CDFER/openRiverSense/images/ATGM332D-5N31-SouthFacingWindow-SkyView.png

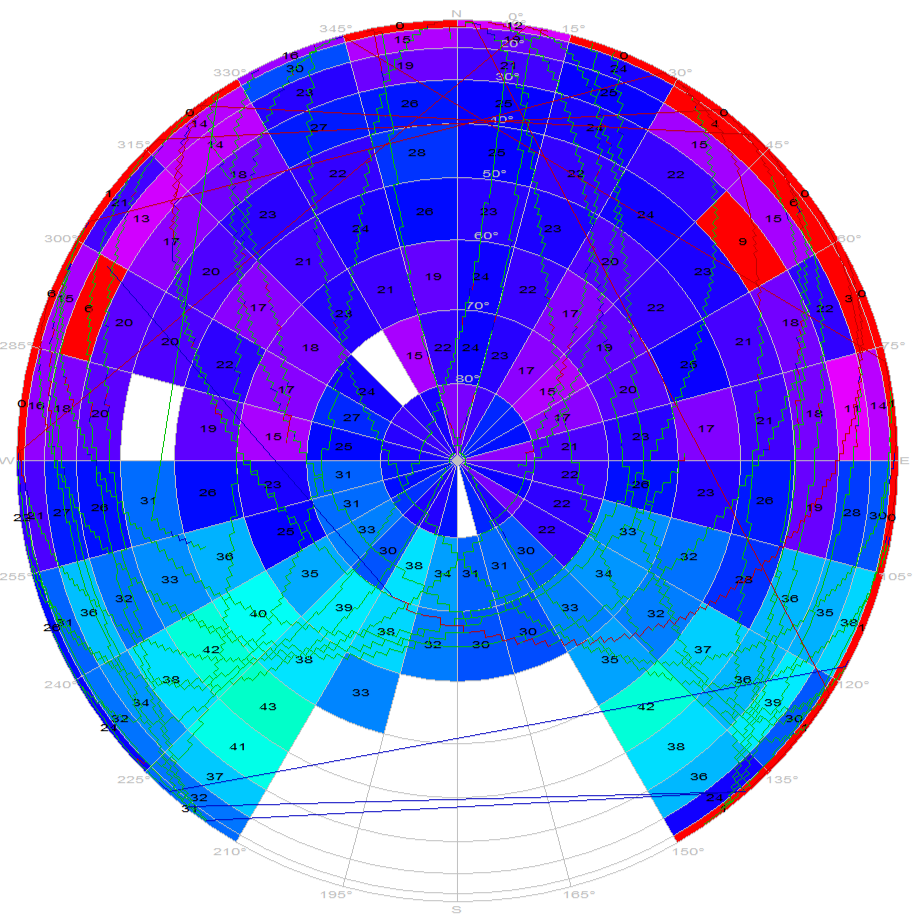
images/ATGM332D-5N31-SouthFacingWindow-SkyView.png
