CDFER/openRiverSense/README.md

**openRiverSense - Water Quality Tester**
=====================================

### Overview

### Features

### Assembly

### Usage

### Improvements for V2

* Reduce interference between Battery Charging and GPS Antenna
* Backlight powered by CC buck power source?
* Better Shielding on Screen SPI bus to enable reliable 80Mhz bus speeds
* Improve GPS RTC backup power source (CR2032, direct from Lithium-ion)?
