CDFER/openRiverSense/images/ATGM332D-5N31-SouthFacingWindow-Deviation.png

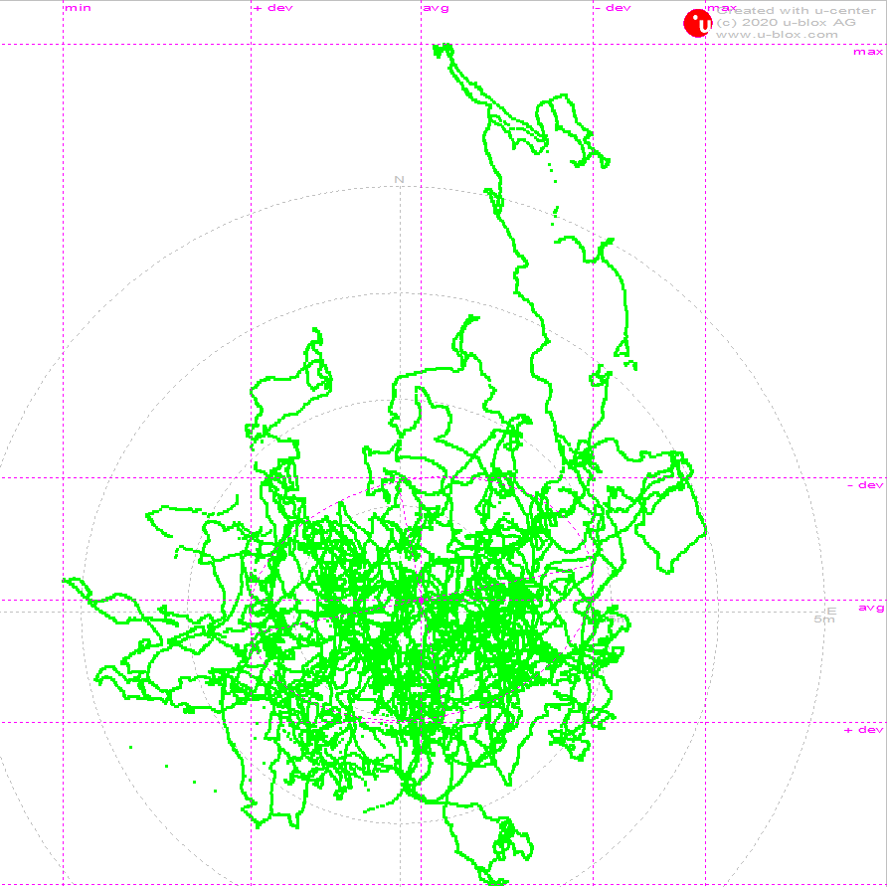
images/ATGM332D-5N31-SouthFacingWindow-Deviation.png
