CDFER/openRiverSense/hardware/openRiverSense/Buttons.3mf

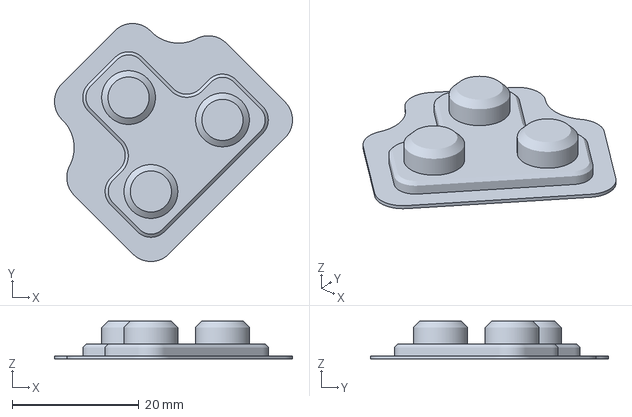
[picture p3: CAD file, 2024-08-28]
hardware/openRiverSense/Buttons.3mf
37.6 x 37.6 x 6.00 mm
