CDFER/openRiverSense/hardware/openRiverSense/Bottom Shell.3mf

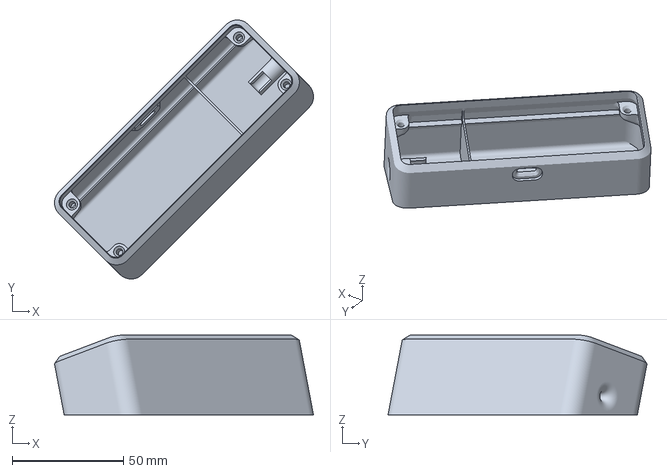
[picture p4: CAD file, 2024-08-28]
hardware/openRiverSense/Bottom Shell.3mf
116.2 x 116.2 x 35.8 mm
