CDFER/openRiverSense/hardware/openRiverSense/Top Shell.stl

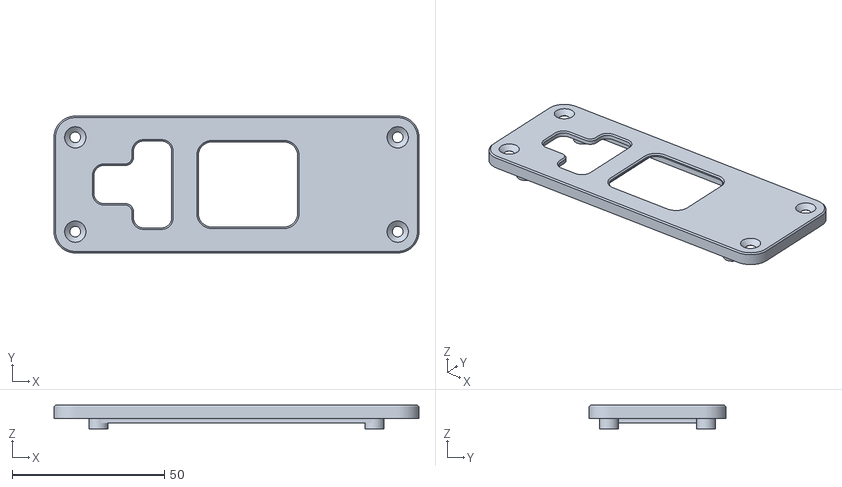
[picture p5: CAD file, 2024-08-28]
hardware/openRiverSense/Top Shell.stl
120.0 x 45.0 x 7.85
