CDFER/openRiverSense/(list of files, cad)

Other CAD files:
hardware/openRiverSense/Bottom Shell.stl
