CDFER/openRiverSense/hardware/probeDaughterBoard/probeDaughterBoard.kicad_pcb

## KiCad design hardware/probeDaughterBoard/probeDaughterBoard.kicad_pcb (2024-08-28)

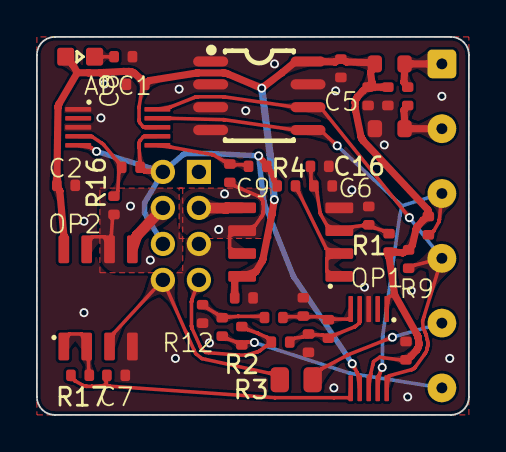
[picture p6: board probeDaughterBoard.kicad_pcb from above]

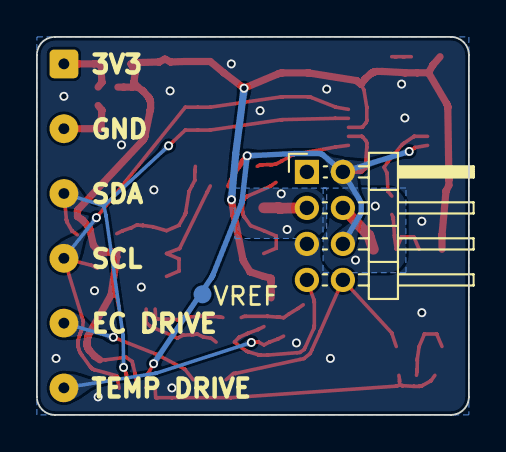
[picture p7: board probeDaughterBoard.kicad_pcb from below]

Board: 2 copper layers, 24.0 x 21.0 mm, 41 parts (2 on the bottom side), 25 nets.

Parts:
ADC1, ADC2: ADS1015; MSOP-10_L3.0-W3.0-P0.50-LS5.0-BL
C1, C2, C3, C5, C6: 100nF; 0402_1005Metric
C4: 0402,10uF,6.3V,X5R; 0402_1005Metric
C7, C9, C11: 0402,20pF,50V,C0G; 0402_1005Metric
C8, C12: 0402,100nF,16V,X7R; 0402_1005Metric
C10, C16: 0402,1uF,25V,X5R; 0402_1005Metric
C13: 0402,220nF,16V,X7R; 0402_1005Metric
C14, C15: 0402,22nF,50V,X7R; 0402_1005Metric
EEPROM1: M24C64-RMN6TP; SOIC-8_L5.0-W4.0-P1.27-LS6.0-BL
FB1, FB2: 0603,200mA; 0603_1608Metric
J1: Conn_02x04_Odd_Even; PinHeader_2x04_P2.00mm_Horizontal
J4: Conn_01x06; SolderWire-0.1sqmm_1x06_P3.6mm_D0.4mm_OD1mm
LED1: 0603,Green; LED0603
OP1, OP2: MCP6002; SOIC-8_L4.9-W3.9-P1.27-LS6.0-BL
R1: 0402,2.2k; 0402_1005Metric
R2, R11, R12: 0402,10k; 0402_1005Metric
R3: 0805,470k; 0805_2012Metric
R4, R13, R14, R15, R16, R17: 0402,100; 0402_1005Metric
R5: 0402,47k; 0402_1005Metric
R6: 0402,12k; 0402_1005Metric
R9, R10: 0402,4.7k; 0402_1005Metric

Connections:
+3.3V: ADC1.8 (VDD), ADC2.1 (ADDR), ADC2.8 (VDD), C1.1, C2.1, C3.1, C5.1, C8.1, C10.1, C12.1, EEPROM1.8 (VCC), FB1.1, LED1.2 (A), OP1.8 (+VDD), OP2.8 (+VDD), R6.1, R9.1, R10.1
/3V3_IN: C4.1, FB1.2, J4.1
/EC_DRIVE: J4.5, R3.1
/EC_IN: J1.8, OP2.3 (+), R3.2
/EC_OUT: ADC2.6 (AIN2), C7.1, R17.2
/GND_IN: C4.2, FB2.2, J4.2
/ORP_IN: J1.4, OP2.5 (+)
/ORP_OUT: ADC1.4 (AIN0), C11.1, R16.2
/ORP_RING: OP2.6 (-), OP2.7, R16.1
/PH_IN: J1.3, OP1.5 (+)
/PH_OUT: ADC1.6 (AIN2), C9.1, R15.2
/PH_RING: OP1.6 (-), OP1.7, R15.1
/SCL: ADC1.10 (SCL), ADC2.10 (SCL), EEPROM1.6 (SCL), J4.4, R9.2
/SDA: ADC1.9 (SDA), ADC2.9 (SDA), EEPROM1.5 (SDA), J4.3, R10.2
/TEMP_DRIVE: J4.6, R2.1, R11.1
/TEMP_IN: J1.7, R2.2, R14.1
/TEMP_REF: R11.2, R12.1, R13.1
/VREF: ADC1.5 (AIN1), ADC1.7 (AIN3), ADC2.7 (AIN3), C9.2, C11.2, J1.2, J1.6, R4.2
GND: ADC1.1 (ADDR), ADC1.3 (GND), ADC2.3 (GND), C1.2, C2.2, C3.2, C5.2, C6.2, C7.2, C8.2, C10.2, C12.2, C14.2, C15.1, C16.2, EEPROM1.1 (A0), EEPROM1.2 (A1), EEPROM1.3 (A2), EEPROM1.4 (VSS), EEPROM1.7 (#WC), FB2.1, J1.5, OP1.4 (-VSS), OP2.4 (-VSS), R1.2, R5.2, R12.2
unnamed: ADC2.4 (AIN0), C13.1, C15.2, R14.2
unnamed: ADC2.5 (AIN1), C13.2, C14.1, R13.2
unnamed: C6.1, C16.1, OP1.3 (+), R1.1, R6.2
unnamed: LED1.1 (C), R5.1
unnamed: OP1.1, OP1.2 (-), R4.1
unnamed: OP2.1, OP2.2 (-), R17.1
