CDFER/openRiverSense/hardware/openRiverSense/openRiverSense.kicad_pcb

## KiCad design hardware/openRiverSense/openRiverSense.kicad_pcb (2024-08-28)

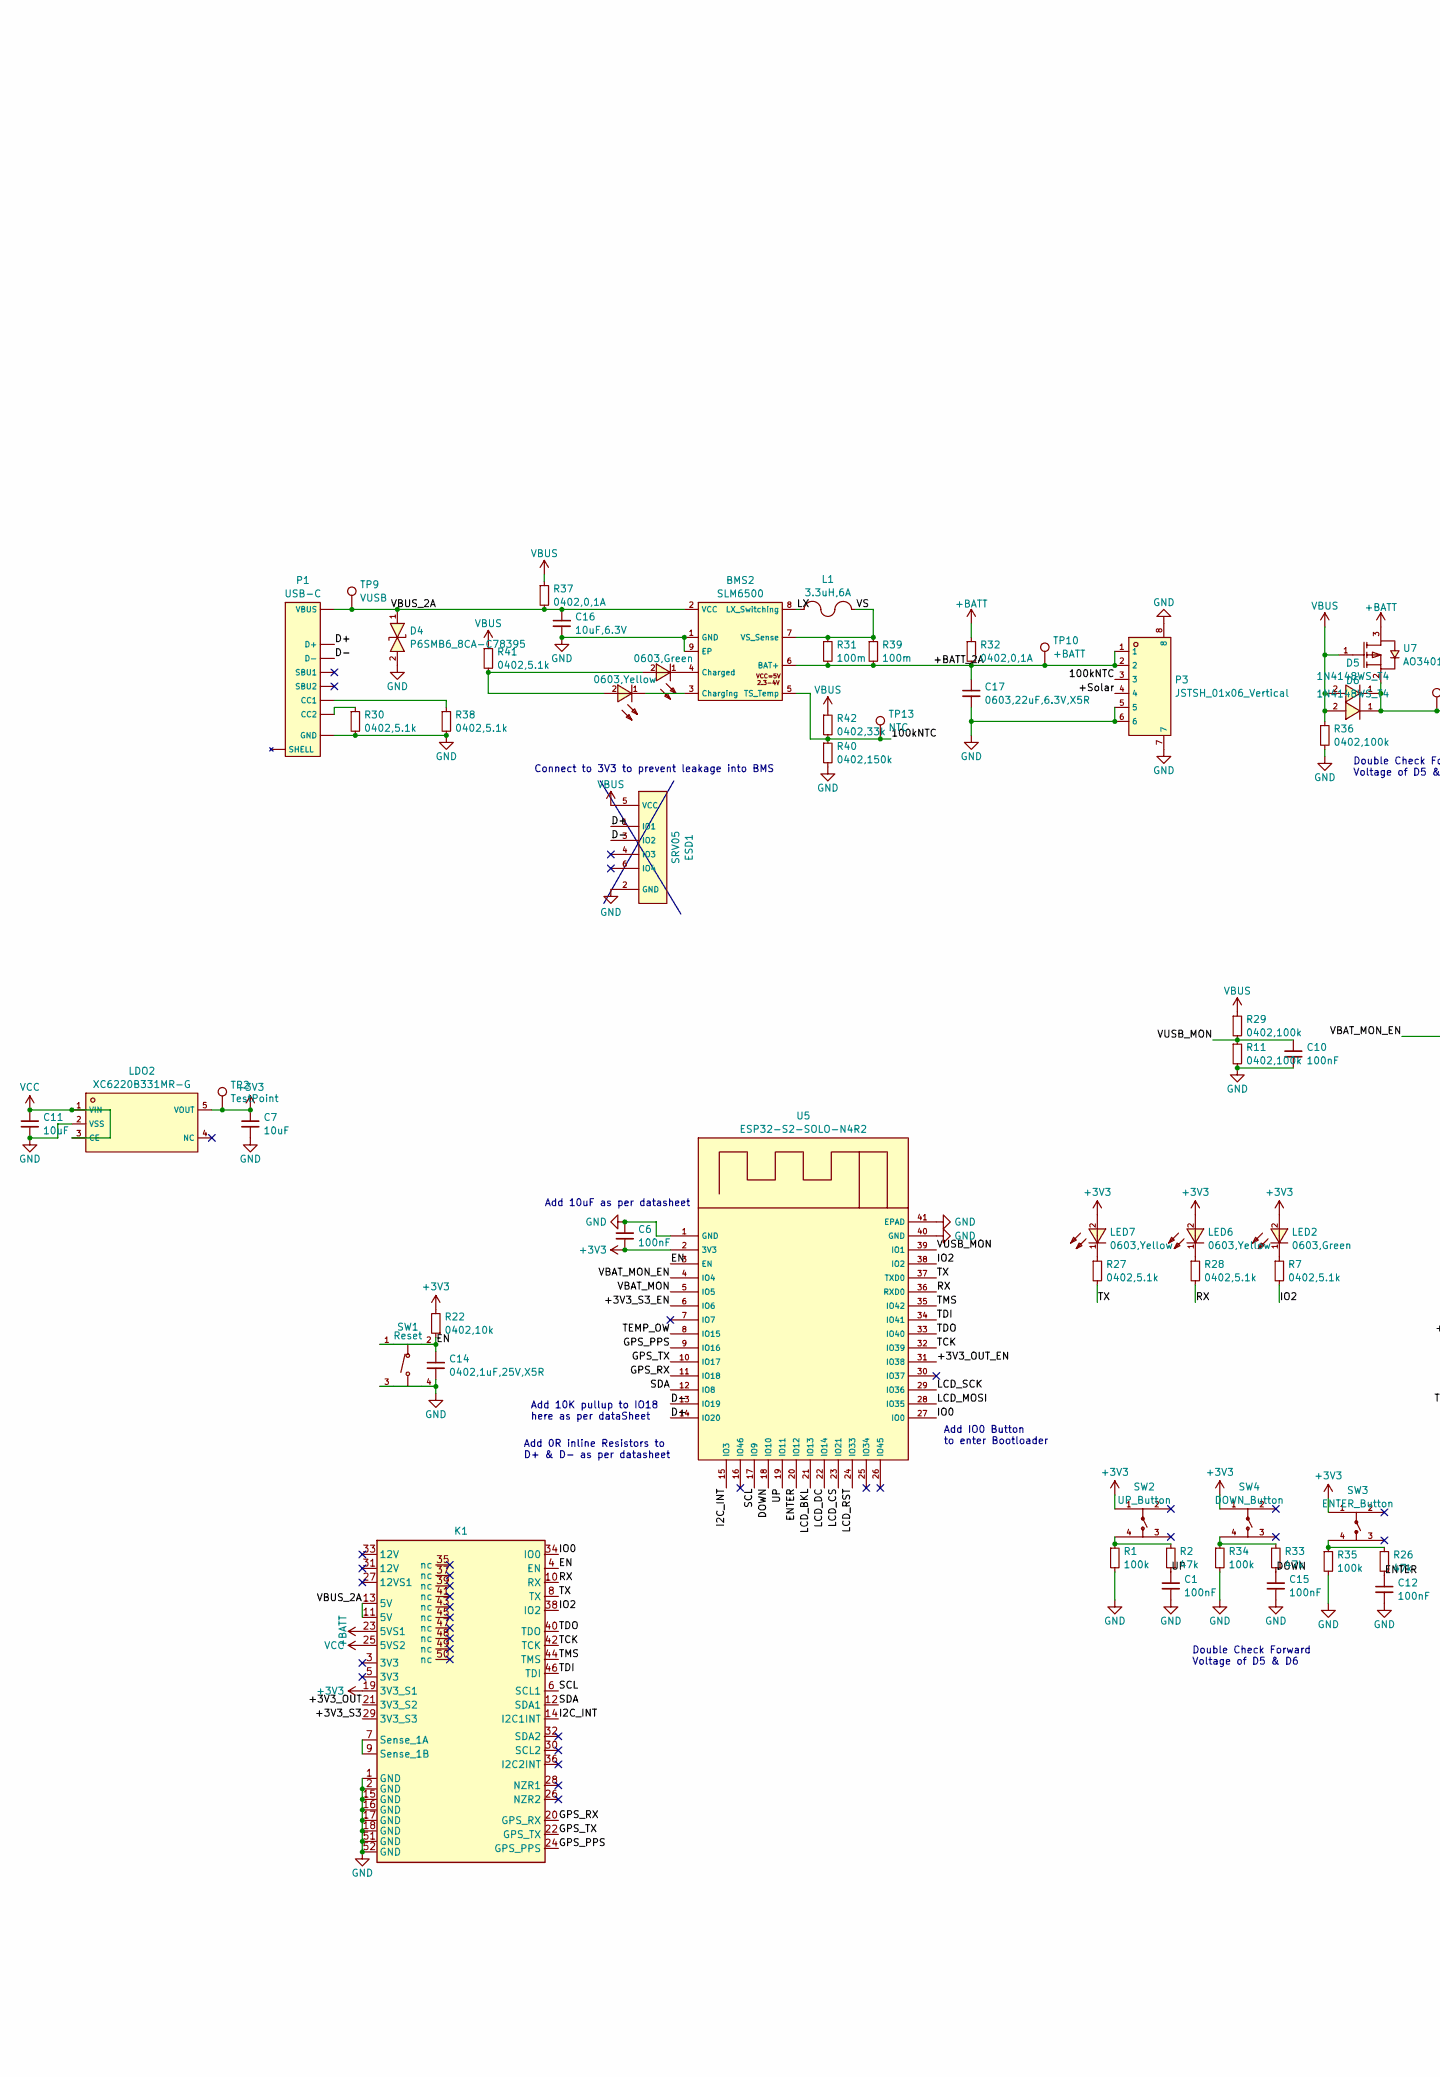
[picture p8: schematic openRiverSense.kicad_sch, part in row 1, column 1]

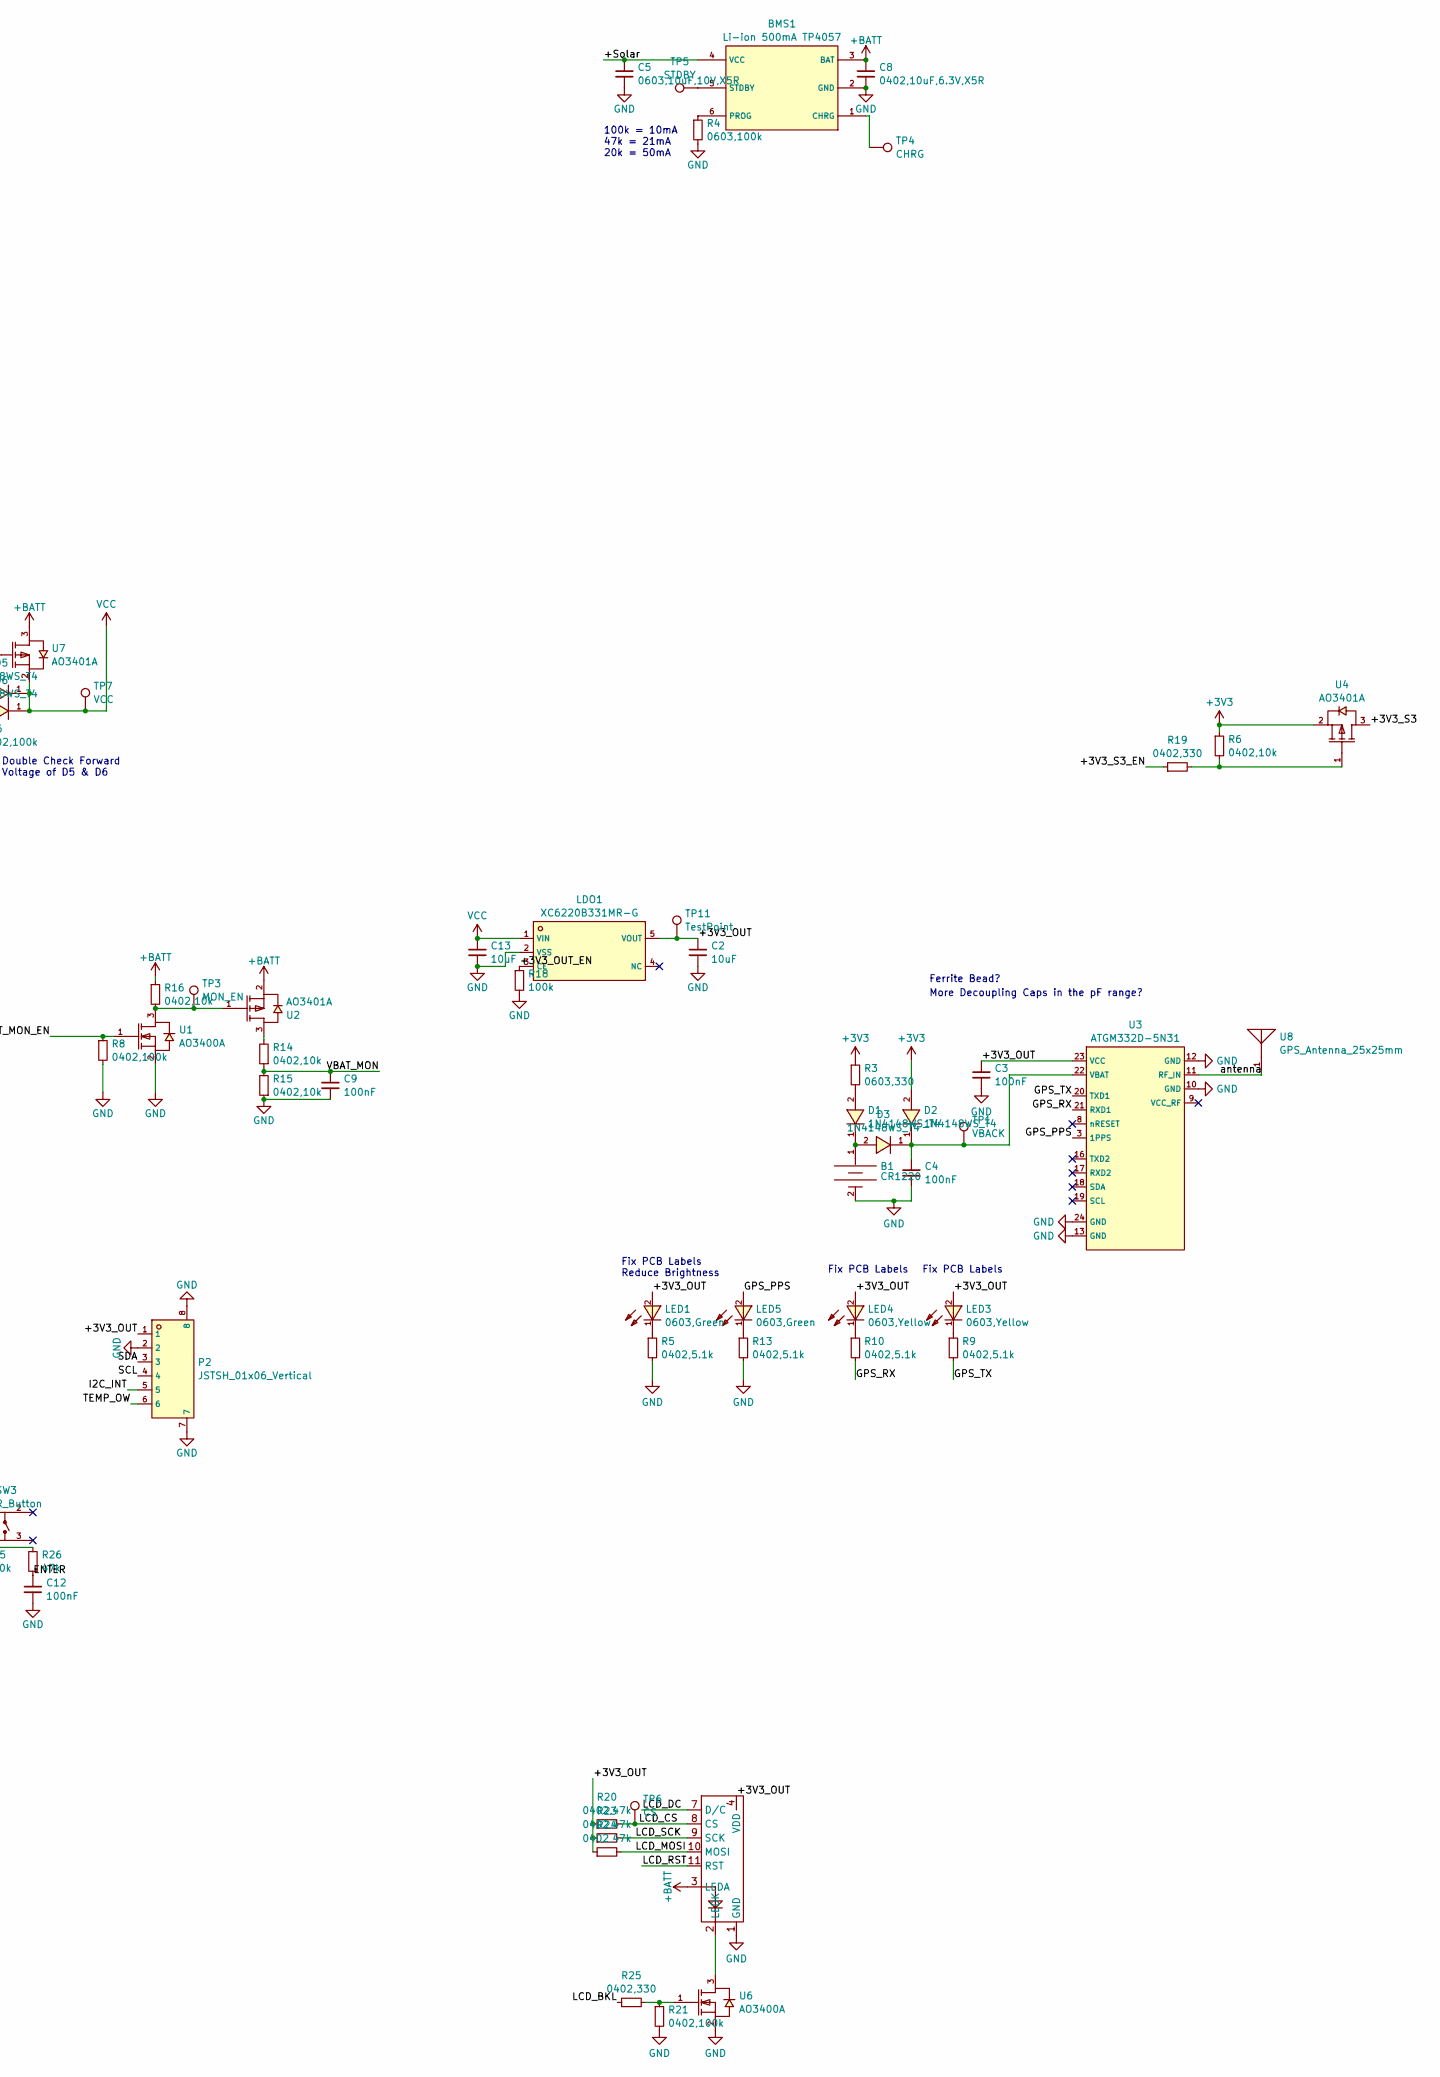
[picture p9: schematic openRiverSense.kicad_sch, part in row 1, column 2]

Parts:
B1: CR1220; BAT-SMD_BS-12-B2AA002; LCSC C964721
BMS1: Li-ion 500mA TP4057; SOT-23-6_L2.9-W1.6-P0.95-LS2.8-BL; LCSC C12044
BMS2: SLM6500; SOP-8_L4.9-W3.9-P1.27-LS6.0-BL-EP; LCSC C130315
C1, C3, C4, C6, C9, C10, C12, C15: 100nF; 0402_1005Metric; MFGPN CL05B104KO5NNNC; LCSC C1525
C2, C7, C11, C13: 10uF; 0402_1005Metric; MFGPN CL05A106MQ5NUNC; LCSC C15525
C5: 0603,10uF,10V,X5R; 0603_1608Metric; MFGPN CL10A106KP8NNNC; LCSC C19702
C8: 0402,10uF,6.3V,X5R; 0402_1005Metric; MFGPN CL05A106MQ5NUNC; LCSC C15525
C14: 0402,1uF,25V,X5R; 0402_1005Metric; MFGPN CL05A105KA5NQNC; LCSC C52923
C16: 10uF,6.3V; 0402_1005Metric; MFGPN CL05A106MQ5NUNC; LCSC C15525
C17: 0603,22uF,6.3V,X5R; 0603_1608Metric; MFGPN CL10A226MQ8NRNC; LCSC C59461
D1, D2, D3, D5, D6: 1N4148WS_T4; SOD-323_L1.8-W1.3-LS2.5-RD; LCSC C2128
D4: P6SMB6_8CA-C78395; SMB_L4.6-W3.6-LS5.3-BI; LCSC C78395
ESD1: SRV05; SOT-23-6_L2.9-W1.6-P0.95-LS2.8-BR; LCSC C85364
K1: mpcie-full-card
L1: 3.3uH,6A; IND-SMD_L7.3-W6.8; LCSC C394166
LDO1, LDO2: XC6220B331MR-G; SOT-25_L3.0-W1.6-P0.95-LS2.8-TL; LCSC C86534
LED1, LED2, LED5, LED9: 0603,Green; LED0603; LCSC C72043
LED3, LED4, LED6, LED7, LED8: 0603,Yellow; LED0603; LCSC C72038
P1: USB-C; USB-C-SMD_G-SWITCH_GT-USB-7010ASV; LCSC C2988369
P2, P3: JSTSH_01x06_Vertical; CONN-SMD_6P-P1.00_DEALON_1.0-6PS; LCSC C2904988
R1, R18, R34, R35: 100k; 0402_1005Metric; MFGPN 0402WGF1003TCE; LCSC C25741
R2, R26, R33: 47k; 0402_1005Metric; MFGPN 0402WGF4702TCE; LCSC C25792
R3: 0603,330; 0603_1608Metric; MFGPN 0603WAF3300T5E; LCSC C23138
R4: 0603,100k; 0603_1608Metric; MFGPN 0603WAF1003T5E; LCSC C25803
R5, R7, R9, R10, R13, R27, R28, R30, R38, R41: 0402,5.1k; 0402_1005Metric; MFGPN 0402WGF5101TCE; LCSC C25905
R6, R14, R15, R16, R22: 0402,10k; 0402_1005Metric; MFGPN 0402WGF1002TCE; LCSC C25744
R8, R11, R21, R29, R36: 0402,100k; 0402_1005Metric; MFGPN 0402WGF1003TCE; LCSC C25741
R19, R25: 0402,330; 0402_1005Metric; MFGPN 0402WGF3300TCE; LCSC C25104
R20, R23, R24: 0402,47k; 0402_1005Metric; MFGPN 0402WGF4702TCE; LCSC C25792
R31, R39: 100m; 1206_3216Metric; MFGPN 1206W4F100LT5E; LCSC C25334
R32, R37: 0402,0,1A; 0402_1005Metric; MFGPN 0402WGF0000TCE; LCSC C17168
R40: 0402,150k; 0402_1005Metric; MFGPN 0402WGF1503TCE; LCSC C25755
R42: 0402,33k; 0402_1005Metric; MFGPN 0402WGF3302TCE; LCSC C25779
SW1: Reset; SW-SMD_4P-L5.1-W5.1-P3.70-LS6.5-TL-2; LCSC C318884
SW2: UP_Button; SW-TH_4P-L12.0-W12.0-P5.00-LS12.5-EH; LCSC C718965
SW3: ENTER_Button; SW-TH_4P-L12.0-W12.0-P5.00-LS12.5-EH; LCSC C718965
SW4: DOWN_Button; SW-TH_4P-L12.0-W12.0-P5.00-LS12.5-EH; LCSC C718965
TFT1: IPS Display
TP1: VBACK; TestPoint_Pad_D1.0mm
TP2, TP11: TestPoint; TestPoint_Pad_D1.0mm
TP3: MON_EN; TestPoint_Pad_D1.0mm
TP4: CHRG; TestPoint_Pad_D1.0mm
TP5: STDBY; TestPoint_Pad_D1.0mm
TP6: CS; TestPoint_Pad_D1.0mm
TP7: VCC; TestPoint_Pad_D1.0mm
TP9: VUSB; TestPoint_Pad_D1.0mm
TP10: +BATT; TestPoint_Pad_D1.0mm
TP13: NTC; TestPoint_Pad_D1.0mm
U1, U6: AO3400A; SOT-23-3_L2.9-W1.6-P1.90-LS2.8-BR; LCSC C20917
U2, U4, U7: AO3401A; SOT-23_L2.9-W1.3-P1.90-LS2.4-BR; LCSC C15127
U3: ATGM332D-5N31; GSM-SMD_ATGM332D-5N31; LCSC C128659
U5: ESP32-S2-SOLO-N4R2; WIRELM-SMD_ESP32-S3-WROOM-1; LCSC C3013947
U8: GPS_Antenna_25x25mm; ANT-TH_KH-GPS252504-WY; LCSC C962216

Connections:
+3V3: C6.2, C7.1, D2.2 (A), K1.19 (3V3_S1), LDO2.5 (VOUT), LED2.2 (A), LED6.2 (A), LED7.2 (A), R3.1, R6.1, R22.2, SW2.1, SW3.1, SW4.1, TP2.1, U4.2 (S), U5.2 (3V3)
+BATT: BMS1.3 (BAT), C8.1, K1.23 (5VS1), R16.1, R32.1, TFT1.3 (LEDA), U2.2 (S), U7.3 (D)
/100kNTC: BMS2.5 (TS_Temp), P3.3, R40.1, R42.2, TP13.1
/+3V3_OUT: C2.1, C3.1, K1.21 (3V3_S2), LDO1.5 (VOUT), LED1.2 (A), LED3.2 (A), LED4.2 (A), P2.1, R20.1, R23.1, R24.1, TFT1.4 (VDD), TP11.1, U3.23 (VCC)
/+3V3_OUT_EN: LDO1.3 (CE), R18.1, U5.31 (IO38)
/+3V3_S3: K1.29 (3V3_S3), U4.3 (D)
/+3V3_S3_EN: R19.1, U5.6 (IO6)
/+BATT_2A: BMS2.6 (BAT+), C17.1, P3.1, P3.2, R31.2, R32.2, R39.2, TP10.1
/+Solar: BMS1.4 (VCC), C5.1, P3.4
/D+: ESD1.1 (IO1), P1.DP (D+), U5.14 (IO20)
/D-: ESD1.3 (IO2), P1.DN (D-), U5.13 (IO19)
/DOWN: C15.1, R33.1, U5.18 (IO10)
/EN: C14.1, K1.4 (EN), R22.1, SW1.1 (A), SW1.2 (B), U5.3 (EN)
/ENTER: C12.1, R26.1, U5.20 (IO12)
/GPS_PPS: K1.24 (GPS_PPS), LED5.2 (A), U3.3 (1PPS), U5.9 (IO16)
/GPS_RX: K1.20 (GPS_RX), R10.2, U3.21 (RXD1), U5.11 (IO18)
/GPS_TX: K1.22 (GPS_TX), R9.2, U3.20 (TXD1), U5.10 (IO17)
/I2C_INT: K1.14 (I2C1INT), P2.5, U5.15 (IO3)
/IO0: K1.34 (IO0), U5.27 (IO0)
/IO2: K1.38 (IO2), R7.2, U5.38 (IO2)
/LCD_BKL: R25.1, U5.21 (IO13)
/LCD_CS: R20.2, TFT1.8 (CS), TP6.1, U5.23 (IO21)
/LCD_DC: TFT1.7 (D/C), U5.22 (IO14)
/LCD_MOSI: R24.2, TFT1.10 (MOSI), U5.28 (IO35)
/LCD_RST: TFT1.11 (RST), U5.24 (IO33)
/LCD_SCK: R23.2, TFT1.9 (SCK), U5.29 (IO36)
/LX: BMS2.8 (LX_Switching), L1.1
/RX: K1.10 (RX), R28.2, U5.36 (RXD0)
/SCL: K1.6 (SCL1), P2.4, U5.17 (IO9)
/SDA: K1.12 (SDA1), P2.3, U5.12 (IO8)
/TCK: K1.42 (TCK), U5.32 (IO39)
/TDI: K1.46 (TDI), U5.34 (IO41)
/TDO: K1.40 (TDO), U5.33 (IO40)
/TEMP_OW: P2.6, U5.8 (IO15)
/TMS: K1.44 (TMS), U5.35 (IO42)
/TX: K1.8 (TX), R27.2, U5.37 (TXD0)
/UP: C1.1, R2.1, U5.19 (IO11)
/VBAT_MON: C9.1, R14.1, R15.2, U5.5 (IO5)
/VBAT_MON_EN: R8.1, U1.1 (G), U5.4 (IO4)
/VBUS_2A: BMS2.2 (VCC), C16.1, D4.1, K1.11 (5V), K1.13 (5V), P1.3 (VBUS), R37.2, TP9.1
/VS: BMS2.7 (VS_Sense), L1.2, R31.1, R39.1
/VUSB_MON: C10.1, R11.1, R29.2, U5.39 (IO1)
/antenna: U3.11 (RF_IN), U8.1 (ANT)
GND: B1.2 (-), BMS1.2 (GND), BMS2.1 (GND), BMS2.9 (EP), C1.2, C2.2, C3.2, C4.2, C5.2, C6.1, C7.2, C8.2, C9.2, C10.2, C11.2, C12.2, C13.2, C14.2, C15.2, C16.2, C17.2, D4.2, ESD1.2 (GND), K1.1 (GND), K1.2 (GND), K1.15 (GND), K1.16 (GND), K1.17 (GND), K1.18 (GND), K1.51 (GND), K1.52 (GND), LDO1.2 (VSS), LDO2.2 (VSS), P1.2 (GND), P2.2, P2.7, P2.8, P3.5, P3.6, P3.7, P3.8, R1.2, R4.2, R5.2, R8.2, R11.2, R13.2, R15.1, R18.2, R21.2, R30.2, R34.2, R35.2, R36.2, R38.2, R40.2, SW1.3 (C), SW1.4 (D), TFT1.1 (GND), U1.2 (S), U3.10 (GND), U3.12 (GND), U3.13 (GND), U3.24 (GND), U5.1 (GND), U5.40 (GND), U5.41 (EPAD), U6.2 (S)
unnamed: B1.1 (+), D1.1 (K), D3.2 (A)
unnamed: BMS1.1 (CHRG), TP4.1
unnamed: BMS1.6 (PROG), R4.1
unnamed: BMS1.5 (STDBY), TP5.1
unnamed: BMS2.4 (Charged), LED9.1 (C)
unnamed: BMS2.3 (Charging), LED8.1 (C)
unnamed: D1.2 (A), R3.2
unnamed: C4.1, D2.1 (K), D3.1 (K), TP1.1, U3.22 (VBAT)
unnamed: K1.7 (Sense_1A), K1.9 (Sense_1B)
unnamed: LED1.1 (C), R5.1
unnamed: LED2.1 (C), R7.1
unnamed: LED3.1 (C), R9.1
unnamed: LED4.1 (C), R10.1
unnamed: LED5.1 (C), R13.1
unnamed: LED6.1 (C), R28.1
unnamed: LED7.1 (C), R27.1
unnamed: LED8.2 (A), LED9.2 (A), R41.2
unnamed: P1.CC1, R38.1
unnamed: P1.CC2, R30.1
unnamed: R1.1, R2.2, SW2.4
unnamed: R26.2, R35.1, SW3.4
unnamed: R33.2, R34.1, SW4.4
unnamed: TFT1.2 (LEDK), U6.3 (D)
unnamed: R16.2, TP3.1, U1.3 (D), U2.1 (G)
unnamed: R14.2, U2.3 (D)
unnamed: R6.2, R19.2, U4.1 (G)
unnamed: R21.1, R25.2, U6.1 (G)
VBUS: D5.2 (A), D6.2 (A), ESD1.5 (VCC), R29.1, R36.1, R37.1, R41.1, R42.1, U7.1 (G)
VCC: C11.1, C13.1, D5.1 (K), D6.1 (K), K1.25 (5VS2), LDO1.1 (VIN), LDO2.1 (VIN), LDO2.3 (CE), TP7.1, U7.2 (S)

Notes on the sheet:
Add 10K pullup to IO18 here as per dataSheet
Double Check Forward Voltage of D5 & D6
Add 10uF as per datasheet
More Decoupling Caps in the pF range?
Fix PCB Labels Reduce Brightness
Fix PCB Labels
Add 0R inline Resistors to D+ & D- as per datasheet
Ferrite Bead?
Add IO0 Button to enter Bootloader
Connect to 3V3 to prevent leakage into BMS
100k = 10mA 47k = 21mA 20k = 50mA

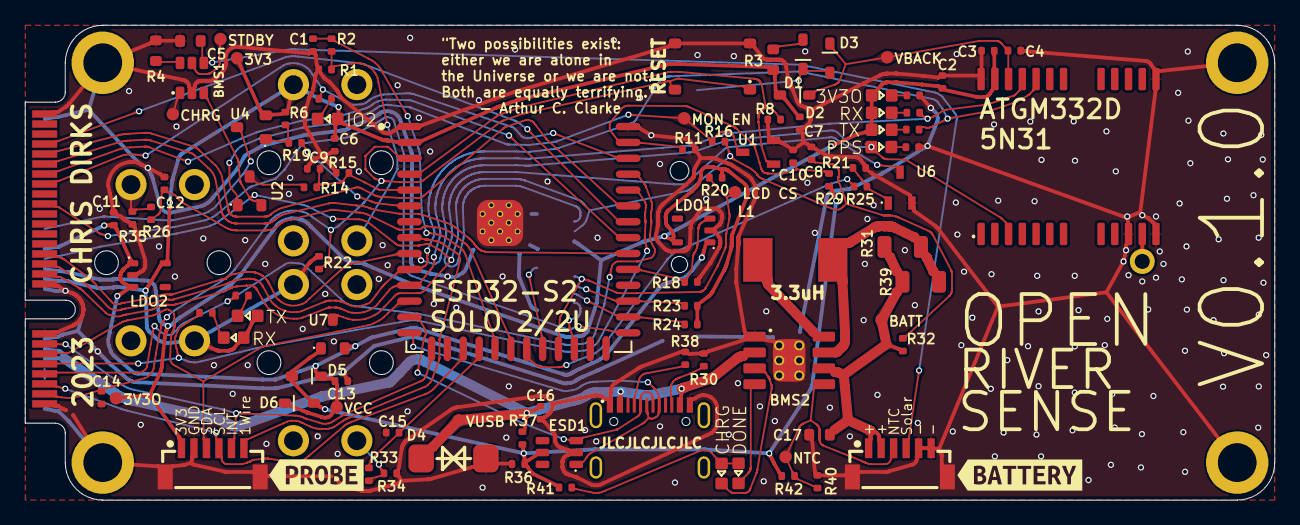
[picture p10: board openRiverSense.kicad_pcb from above]

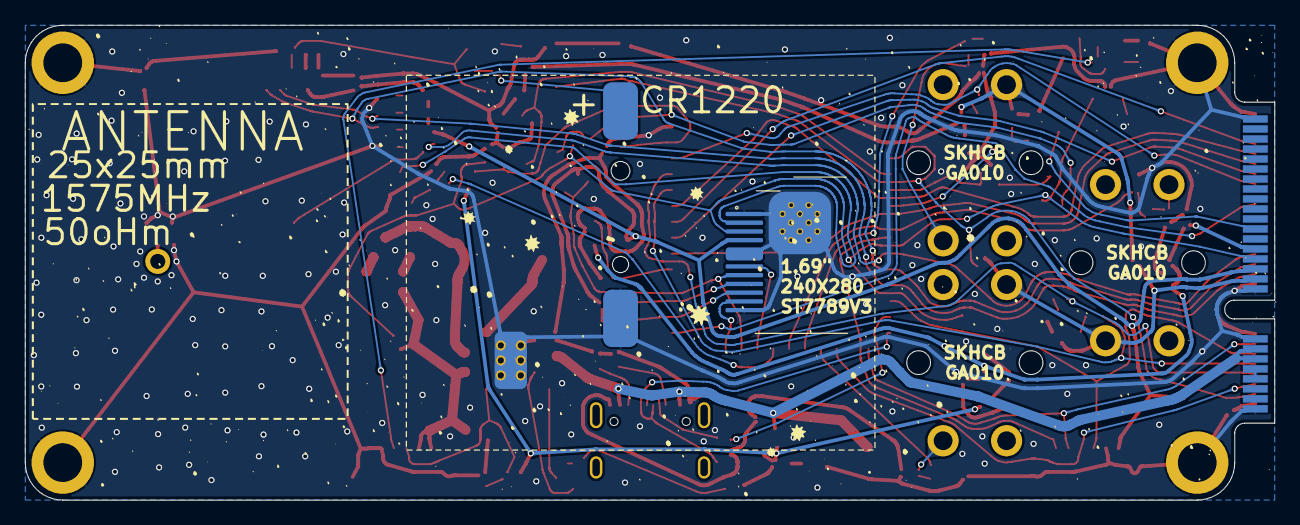
[picture p11: board openRiverSense.kicad_pcb from below]

Board: 2 copper layers, 100.0 x 38.0 mm, 109 parts (7 on the bottom side), 73 nets.

Other parts of the board:
kibuzzard-1: G***; kibuzzard-651F6E89
kibuzzard-2: G***; kibuzzard-651F6E67
