CDFER/openRiverSense/src/usb.h

#include "Adafruit_SPIFlash.h"
#include "Adafruit_TinyUSB.h"
#include "SPI.h"
#include "SdFat.h"

// file system object from SdFat
FatVolume fatfs;

// ESP32 use same flash device that store code.
// Therefore there is no need to specify the SPI and SS
Adafruit_FlashTransport_ESP32 flashTransport;
Adafruit_SPIFlash flash(&flashTransport);

// USB Mass Storage object
Adafruit_USBD_MSC usb_msc;

bool fs_formatted;	// Check if flash is formatted and ready to use
bool fs_changed;	// Set to true when write to flash

// Callback invoked when received READ10 command.
// Copy disk's data to buffer (up to bufsize) and
// return number of copied bytes (must be multiple of block size)
int32_t msc_read_cb(uint32_t lba, void *buffer, uint32_t bufsize) {
	// Note: SPIFLash Bock API: readBlocks/writeBlocks/syncBlocks
	// already include 4K sector caching internally. We don't need to cache it, yahhhh!!
	return flash.readBlocks(lba, (uint8_t *)buffer, bufsize / 512) ? bufsize : -1;
}

// Callback invoked when received WRITE10 command.
// Process data in buffer to disk's storage and
// return number of written bytes (must be multiple of block size)
int32_t msc_write_cb(uint32_t lba, uint8_t *buffer, uint32_t bufsize) {
	// Note: SPIFLash Bock API: readBlocks/writeBlocks/syncBlocks
	// already include 4K sector caching internally. We don't need to cache it, yahhhh!!
	return flash.writeBlocks(lba, buffer, bufsize / 512) ? bufsize : -1;
}

// Callback invoked when WRITE10 command is completed (status received and accepted by host).
// used to flush any pending cache.
void msc_flush_cb(void) {
	// sync with flash
	flash.syncBlocks();

	// clear file system's cache to force refresh
	fatfs.cacheClear();
}

// Invoked when received Test Unit Ready command.
// return true allowing host to read/write this LUN e.g SD card inserted
bool msc_ready_callback(void) {
	// if fs has changed, mark unit as not ready temporarily to force PC to flush cache
	bool ret = !fs_changed;
	fs_changed = false;
	return ret;
}

void refreshMassStorage(void) {
	fs_changed = true;
}

void usbTask(void *parameter) {
	flash.begin();

	// Set disk vendor id, product id and revision with string up to 8, 16, 4 characters respectively
	usb_msc.setID("Kea", "OpenRiverSense", "010");

	// Set callback
	usb_msc.setReadWriteCallback(msc_read_cb, msc_write_cb, msc_flush_cb);

	// Set disk size, block size should be 512 regardless of spi flash page size
	usb_msc.setCapacity(flash.size() / 512, 512);

	// MSC is ready for read/write
	fs_changed = false;
	usb_msc.setReadyCallback(0, msc_ready_callback);

	usb_msc.begin();

	// Init file system on the flash
	fs_formatted = fatfs.begin(&flash);
	if (fs_formatted == false) {
		fatfs.init(&flash);
	}

	vTaskDelete(NULL);
}

/**
 * @brief Get the current date and time as a formatted string.
 *
 * @param format The desired format of the date and time string.
 * @return The current date and time as a formatted string.
 */
const char *getCurrentDateTime(const char *format) {
	static char dateTime[32];
	time_t currentEpoch;
	time(&currentEpoch);
	struct tm *timeInfo = localtime(&currentEpoch);
	strftime(dateTime, sizeof(dateTime), format, timeInfo);
	return dateTime;
}

void saveRecordToFile() {
	if (fs_formatted) {
		File32 dataFile = fatfs.open("waterData.csv", O_WRITE | O_APPEND | O_CREAT);
		// Check that the file opened successfully and write a line to it.
		if (dataFile) {
			if (dataFile.fileSize() == 0) {
				dataFile.print(
					"date(dd-mm-yyyy HH:MM),latitude(deg),Longitude(deg),pH,ORP(mV),Conductivity(uS/cm),Temperature(degC)\n");
			}

			dataFile.printf("%s,%0.6f,%0.6f,%0.2f,%0.0f,%0.0f,%0.1f\n", getCurrentDateTime("%d-%m-%Y %H:%M"),
							gps.location.lat(), gps.location.lng(), pH.value, orp.value, tds.value, temperature);

			dataFile.close();
		}
	}
	refreshMassStorage();
}

void saveAnalyticsToFile(uint16_t batteryMilliVolts, uint16_t screenTime, uint16_t lightSleepTime) {
	if (fs_formatted) {
		File32 dataFile = fatfs.open("analytics.csv", O_WRITE | O_APPEND | O_CREAT);
		// Check that the file opened successfully and write a line to it.
		if (dataFile) {
			if (dataFile.fileSize() == 0) {
				dataFile.print(
					"epoch(s from1970),date(dd-mm-yyyy HH:MM),Battery(mV),HDOP,TTFF(ms),ScreenTime(s),LightSleepTime(s),TotalTime(s)\n");
			}

			time_t currentEpoch;
			time(&currentEpoch);

			dataFile.printf("%i,%s,%i,%i,%i,%i,%i\n", currentEpoch, getCurrentDateTime("%d-%m-%Y %H:%M"), batteryMilliVolts, gps.hdop.value(), gps.timeToFirstFix(), screenTime, lightSleepTime, millis() / 1000);
			dataFile.close();
		}
	}
	refreshMassStorage();
}
