CDFER/openRiverSense/include/gpsOff.h

#define GPSOFF_HEIGHT 20
#define GPSOFF_WIDTH 20

// array size is 800
const uint16_t gpsOff[] PROGMEM  = {
  0x0000, 0x0000, 0x0000, 0x0000, 0x0000, 0x0000, 0x4108, 0x0c63, 0xd7bd, 0x3ce7, 0x5def, 0x59ce, 0xef7b, 0x8210, 0x0000, 0x0000, 0x0000, 0x0000, 0x0000, 0x0000, 
  0x0842, 0x75ad, 0x4108, 0x0000, 0x0000, 0x494a, 0x3ce7, 0xffff, 0xffff, 0xffff, 0xffff, 0xffff, 0xffff, 0x7def, 0x2842, 0x0000, 0x0000, 0x0000, 0x0000, 0x0000, 
  0x96b5, 0xffff, 0xb6b5, 0x4108, 0x0000, 0xb6b5, 0xffff, 0xffff, 0xffff, 0xffff, 0xffff, 0xffff, 0xffff, 0xffff, 0xdfff, 0x2842, 0x0000, 0x0000, 0x0000, 0x0000, 
  0x4108, 0xf7bd, 0xffff, 0xb6b5, 0x4108, 0x4108, 0xb6b5, 0xffff, 0xffff, 0xffff, 0xffff, 0xffff, 0xffff, 0xffff, 0xffff, 0x7def, 0x8210, 0x0000, 0x0000, 0x0000, 
  0x0000, 0x4108, 0xf7bd, 0xffff, 0xb6b5, 0x4108, 0x2000, 0x96b5, 0x9ef7, 0x14a5, 0x14a5, 0xbef7, 0xffff, 0xffff, 0xffff, 0xffff, 0xef7b, 0x0000, 0x0000, 0x0000, 
  0x0000, 0x0000, 0x4108, 0x3ce7, 0xffff, 0xb6b5, 0x4108, 0x2000, 0x0421, 0x0000, 0x0000, 0x8631, 0xbef7, 0xffff, 0xffff, 0xffff, 0x59ce, 0x0000, 0x0000, 0x0000, 
  0x0000, 0x0000, 0x0000, 0x7def, 0xffff, 0xffff, 0xb6b5, 0x4108, 0x0000, 0x0000, 0x0000, 0x0000, 0x14a5, 0xffff, 0xffff, 0xffff, 0x5def, 0x0000, 0x0000, 0x0000, 
  0x0000, 0x0000, 0x0000, 0x9ef7, 0xffff, 0xffff, 0xffff, 0xd7bd, 0x4108, 0x0000, 0x0000, 0x0000, 0x14a5, 0xffff, 0xffff, 0xffff, 0x5def, 0x0000, 0x0000, 0x0000, 
  0x0000, 0x0000, 0x0000, 0x79ce, 0xffff, 0xffff, 0xffff, 0xffff, 0xb6b5, 0x4108, 0x0000, 0xe318, 0x9ef7, 0xffff, 0xffff, 0xffff, 0x59ce, 0x0000, 0x0000, 0x0000, 
  0x0000, 0x0000, 0x0000, 0x3084, 0xffff, 0xffff, 0xffff, 0xffff, 0xffff, 0x96b5, 0x2000, 0x2000, 0x55ad, 0xffff, 0xffff, 0xffff, 0x3084, 0x0000, 0x0000, 0x0000, 
  0x0000, 0x0000, 0x0000, 0x8631, 0xffff, 0xffff, 0xffff, 0xffff, 0xffff, 0xffff, 0x75ad, 0x2000, 0x2000, 0x75ad, 0xffff, 0xffff, 0x0421, 0x0000, 0x0000, 0x0000, 
  0x0000, 0x0000, 0x0000, 0x0000, 0xd7bd, 0xffff, 0xffff, 0xffff, 0xffff, 0xffff, 0xffff, 0xb6b5, 0x2000, 0x2000, 0x75ad, 0x96b5, 0x0000, 0x0000, 0x0000, 0x0000, 
  0x0000, 0x0000, 0x0000, 0x0000, 0x0842, 0xffff, 0xffff, 0xffff, 0xffff, 0xffff, 0xffff, 0xffff, 0x96b5, 0x2000, 0x2000, 0x2421, 0x0000, 0x0000, 0x0000, 0x0000, 
  0x0000, 0x0000, 0x0000, 0x0000, 0x0000, 0x38c6, 0xffff, 0xffff, 0xffff, 0xffff, 0xffff, 0xffff, 0xffff, 0x96b5, 0x2000, 0x0000, 0x0000, 0x0000, 0x0000, 0x0000, 
  0x0000, 0x0000, 0x0000, 0x0000, 0x0000, 0x8631, 0xdfff, 0xffff, 0xffff, 0xffff, 0xffff, 0xffff, 0xffff, 0xffff, 0xb6b5, 0x4108, 0x0000, 0x0000, 0x0000, 0x0000, 
  0x0000, 0x0000, 0x0000, 0x0000, 0x0000, 0x0000, 0xcf7b, 0xffff, 0xffff, 0xffff, 0xffff, 0xffff, 0xffff, 0x5def, 0xffff, 0xb6b5, 0x2000, 0x0000, 0x0000, 0x0000, 
  0x0000, 0x0000, 0x0000, 0x0000, 0x0000, 0x0000, 0x2000, 0x38c6, 0xffff, 0xffff, 0xffff, 0xffff, 0x18c6, 0x6108, 0xf7bd, 0xffff, 0xd7bd, 0x4108, 0x0000, 0x0000, 
  0x0000, 0x0000, 0x0000, 0x0000, 0x0000, 0x0000, 0x0000, 0x0421, 0x7def, 0xffff, 0xffff, 0x7def, 0xe318, 0x0000, 0x6108, 0x18c6, 0xffff, 0x75ad, 0x0000, 0x0000, 
  0x0000, 0x0000, 0x0000, 0x0000, 0x0000, 0x0000, 0x0000, 0x0000, 0x494a, 0xffff, 0xffff, 0x2842, 0x0000, 0x0000, 0x0000, 0x4108, 0xb6b5, 0x494a, 0x0000, 0x0000, 
  0x0000, 0x0000, 0x0000, 0x0000, 0x0000, 0x0000, 0x0000, 0x0000, 0x0000, 0xae73, 0x6d6b, 0x0000, 0x0000, 0x0000, 0x0000, 0x0000, 0x0000, 0x0000, 0x0000, 0x0000
};
