CDFER/openRiverSense/include/gpsOn.h

#define GPSON_HEIGHT 20
#define GPSON_WIDTH 20

// array size is 800
const uint16_t gpsOn[] PROGMEM  = {
  0x0000, 0x0000, 0x0000, 0x0000, 0x0000, 0x0000, 0xa210, 0x3084, 0x79ce, 0x9ef7, 0x9ef7, 0x79ce, 0x1084, 0xa210, 0x0000, 0x0000, 0x0000, 0x0000, 0x0000, 0x0000, 
  0x0000, 0x0000, 0x0000, 0x0000, 0x0000, 0x8a52, 0x9ef7, 0xffff, 0xffff, 0xffff, 0xffff, 0xffff, 0xffff, 0x7def, 0x494a, 0x0000, 0x0000, 0x0000, 0x0000, 0x0000, 
  0x0000, 0x0000, 0x0000, 0x0000, 0xaa52, 0xffff, 0xffff, 0xffff, 0xffff, 0xffff, 0xffff, 0xffff, 0xffff, 0xffff, 0xffff, 0x494a, 0x0000, 0x0000, 0x0000, 0x0000, 
  0x0000, 0x0000, 0x0000, 0xa210, 0x9ef7, 0xffff, 0xffff, 0xffff, 0xffff, 0xffff, 0xffff, 0xffff, 0xffff, 0xffff, 0xffff, 0x9ef7, 0xa210, 0x0000, 0x0000, 0x0000, 
  0x0000, 0x0000, 0x0000, 0x3084, 0xffff, 0xffff, 0xffff, 0xffff, 0x9ef7, 0xf39c, 0xf39c, 0x9ef7, 0xffff, 0xffff, 0xffff, 0xffff, 0x1084, 0x0000, 0x0000, 0x0000, 
  0x0000, 0x0000, 0x0000, 0x9ad6, 0xffff, 0xffff, 0xffff, 0x9ef7, 0x2421, 0x0000, 0x0000, 0x4529, 0x9ef7, 0xffff, 0xffff, 0xffff, 0x79ce, 0x0000, 0x0000, 0x0000, 
  0x0000, 0x0000, 0x0000, 0x9ef7, 0xffff, 0xffff, 0xffff, 0xd39c, 0x0000, 0x0000, 0x0000, 0x0000, 0xf39c, 0xffff, 0xffff, 0xffff, 0x7def, 0x0000, 0x0000, 0x0000, 
  0x0000, 0x0000, 0x0000, 0x7def, 0xffff, 0xffff, 0xffff, 0xd39c, 0x0000, 0x0000, 0x0000, 0x0000, 0xf39c, 0xffff, 0xffff, 0xffff, 0x7def, 0x0000, 0x0000, 0x0000, 
  0x0000, 0x0000, 0x0000, 0x59ce, 0xffff, 0xffff, 0xffff, 0x7def, 0xe318, 0x0000, 0x0000, 0x2421, 0x9ef7, 0xffff, 0xffff, 0xffff, 0x59ce, 0x0000, 0x0000, 0x0000, 
  0x0000, 0x0000, 0x0000, 0x1084, 0xffff, 0xffff, 0xffff, 0xffff, 0x7def, 0xd39c, 0xd39c, 0x9ef7, 0xffff, 0xffff, 0xffff, 0xffff, 0xef7b, 0x0000, 0x0000, 0x0000, 
  0x0000, 0x0000, 0x0000, 0x4529, 0xffff, 0xffff, 0xffff, 0xffff, 0xffff, 0xffff, 0xffff, 0xffff, 0xffff, 0xffff, 0xffff, 0xffff, 0x4529, 0x0000, 0x0000, 0x0000, 
  0x0000, 0x0000, 0x0000, 0x0000, 0xb6b5, 0xffff, 0xffff, 0xffff, 0xffff, 0xffff, 0xffff, 0xffff, 0xffff, 0xffff, 0xffff, 0xd7bd, 0x0000, 0x0000, 0x0000, 0x0000, 
  0x0000, 0x0000, 0x0000, 0x0000, 0xc739, 0xffff, 0xffff, 0xffff, 0xffff, 0xffff, 0xffff, 0xffff, 0xffff, 0xffff, 0xffff, 0x0842, 0x0000, 0x0000, 0x0000, 0x0000, 
  0x0000, 0x0000, 0x0000, 0x0000, 0x0000, 0x18c6, 0xffff, 0xffff, 0xffff, 0xffff, 0xffff, 0xffff, 0xffff, 0xffff, 0x96b5, 0x0000, 0x0000, 0x0000, 0x0000, 0x0000, 
  0x0000, 0x0000, 0x0000, 0x0000, 0x0000, 0x4529, 0xbef7, 0xffff, 0xffff, 0xffff, 0xffff, 0xffff, 0xffff, 0x9ef7, 0xe318, 0x0000, 0x0000, 0x0000, 0x0000, 0x0000, 
  0x0000, 0x0000, 0x0000, 0x0000, 0x0000, 0x0000, 0xae73, 0xffff, 0xffff, 0xffff, 0xffff, 0xffff, 0xffff, 0x2c63, 0x0000, 0x0000, 0x0000, 0x0000, 0x0000, 0x0000, 
  0x0000, 0x0000, 0x0000, 0x0000, 0x0000, 0x0000, 0x0000, 0x18c6, 0xffff, 0xffff, 0xffff, 0xffff, 0xd7bd, 0x0000, 0x0000, 0x0000, 0x0000, 0x0000, 0x0000, 0x0000, 
  0x0000, 0x0000, 0x0000, 0x0000, 0x0000, 0x0000, 0x0000, 0xe318, 0x5def, 0xffff, 0xffff, 0x5def, 0xc318, 0x0000, 0x0000, 0x0000, 0x0000, 0x0000, 0x0000, 0x0000, 
  0x0000, 0x0000, 0x0000, 0x0000, 0x0000, 0x0000, 0x0000, 0x0000, 0x0842, 0xdfff, 0xffff, 0x2842, 0x0000, 0x0000, 0x0000, 0x0000, 0x0000, 0x0000, 0x0000, 0x0000, 
  0x0000, 0x0000, 0x0000, 0x0000, 0x0000, 0x0000, 0x0000, 0x0000, 0x0000, 0x6d6b, 0x8e73, 0x0000, 0x0000, 0x0000, 0x0000, 0x0000, 0x0000, 0x0000, 0x0000, 0x0000
};
