CDFER/openRiverSense/src/gui.h

#include <Arduino.h>
#include <MenuSystem.h>
#include <tft_eSPI.h>

#include "MaterialSymbols24.h"
#include "Roboto-Bold-24.h"
#include "Roboto-Bold-48.h"
#include "gpsOff.h"
#include "gpsOn.h"

RTC_DATA_ATTR static char batteryText[6] = "100%";
extern RTC_DATA_ATTR uint16_t batteryMilliVolts;
extern RTC_DATA_ATTR float averageGPSTimeToLocationFixSeconds;
// extern CalibratedSensor pH;
// extern CalibratedSensor orp;
// extern CalibratedSensor tds;

TFT_eSPI screen;
TFT_eSprite topGui = TFT_eSprite(&screen);
TFT_eSprite menuBuffer = TFT_eSprite(&screen);	//~40kb in size

#define MENU_WIDTH 240
#define MENU_HEIGHT 200
#define MENU_ITEM_HEIGHT 48
#define BACKLIGHT_VOLTAGE_mV 1400.0

enum ButtonStates : uint8_t { NOT_PRESSED = 0,
							  UP_PRESSED,
							  DOWN_PRESSED,
							  WAKE_PRESSED };
volatile ButtonStates buttonState = NOT_PRESSED;
bool buttonPressed = false;
uint8_t topGuiCounter = 0;
uint8_t brightnessPWM = 0;

void IRAM_ATTR
buttonISR() {
	if (digitalRead(WAKE_BUTTON)) {
		buttonState = WAKE_PRESSED;
	} else if (digitalRead(UP_BUTTON)) {
		buttonState = UP_PRESSED;
	} else if (digitalRead(DOWN_BUTTON)) {
		buttonState = DOWN_PRESSED;
	} else {
		buttonState = NOT_PRESSED;
	}
	buttonPressed = true;
}

uint8_t menuIndex;

class MyRenderer : public MenuComponentRenderer {
  public:
	void render(Menu const &menu) const {
		menuBuffer.fillSprite(TFT_BLACK);

		for (menuIndex = 0; menuIndex < menu.get_num_components(); ++menuIndex) {
			MenuComponent const *currentComponent = menu.get_menu_component(menuIndex);
			currentComponent->render(*this);
		}

		menuBuffer.pushSprite(20, 40);
	}

	void render_menu_item(MenuItem const &item) const {
		renderComponent(menuIndex, item.is_current(), item.get_name(), item.get_icon());
	}

	void render_back_menu_item(BackMenuItem const &item) const {
		renderComponent(menuIndex, item.is_current(), item.get_name(), item.get_icon());
	}

	void render_numeric_menu_item(NumericMenuItem const &item) const {
		renderComponent(menuIndex, item.is_current(), item.get_name(), item.get_icon());
		if (item.has_focus()) {
			menuBuffer.printf(" %0.1f <", item.get_value());
		} else {
			menuBuffer.printf(" %0.1f", item.get_value());
		}
	}

	void render_menu(Menu const &menu) const {
		renderComponent(menuIndex, menu.is_current(), menu.get_name(), menu.get_icon());
	}

	void renderComponent(uint8_t index, bool highlight, const char *name, const char *icon) const {
		if (highlight) {
			menuBuffer.fillRoundRect(0, (index)*MENU_ITEM_HEIGHT, MENU_WIDTH, MENU_ITEM_HEIGHT, MENU_ITEM_HEIGHT / 2,
									 TFT_DARKGREY);
		}

		if (icon != nullptr) {
			menuBuffer.loadFont(MaterialSymbols24);
			menuBuffer.setTextDatum(MC_DATUM);
			menuBuffer.drawString(icon, MENU_ITEM_HEIGHT / 2, (index + 1) * MENU_ITEM_HEIGHT - 20);
		}

		menuBuffer.loadFont(Roboto_Bold_24);
		menuBuffer.setTextDatum(CL_DATUM);
		menuBuffer.drawString(name, MENU_ITEM_HEIGHT + 5, (index + 1) * MENU_ITEM_HEIGHT - 22);
	}
};
MyRenderer menuRenderer;

void updateScreenBrightness(bool screenOn = true) {
	float newBrightnessPWM;
	if (screenOn && 5000 > batteryMilliVolts > 0) {
		newBrightnessPWM = ((float)BACKLIGHT_VOLTAGE_mV / (float)batteryMilliVolts) * 255.0;
	} else {
		newBrightnessPWM = 0;
	}

	if (brightnessPWM != (uint8_t)newBrightnessPWM) {
		brightnessPWM = (uint8_t)newBrightnessPWM;
		analogWrite(BACKLIGHT, brightnessPWM);
	}
}

void drawTopGui() {
	if (topGuiCounter <= 0) {
		topGui.fillSprite(TFT_BLACK);
		topGui.setTextDatum(CL_DATUM);

		static char timeText[7];
		time_t currentEpoch;
		time(&currentEpoch);
		struct tm *timeInfo = localtime(&currentEpoch);
		strftime(timeText, sizeof(timeText), "%H:%M", timeInfo);

		topGui.drawString(timeText, 0, 10);
		topGui.setTextDatum(CR_DATUM);

		topGui.drawString(batteryText, 200, 10);
		if (gps.location.isValid()) {
			topGui.pushImage(110, 0, 20, 20, gpsOn);
		} else {
			topGui.pushImage(110, 0, 20, 20, gpsOff);
		}

		topGui.pushSprite(40, 10);
		updateScreenBrightness();
		topGuiCounter = 20;
	} else {
		topGuiCounter--;
	}
}

void setupMenuBuffer() {
	menuBuffer.fillSprite(TFT_BLACK);
	menuBuffer.loadFont(Roboto_Bold_24);
	menuBuffer.setCursor(0, 0);
}

void waitForButtonPress() {
	vTaskDelay(200 / portTICK_PERIOD_MS);
	buttonState = NOT_PRESSED;
	while (buttonState == NOT_PRESSED) {
		drawTopGui();
		vTaskDelay(50 / portTICK_PERIOD_MS);
	}
}

bool drawSpinner(uint16_t totalTimeSeconds) {
	static char timeText[10];
	const uint32_t x = MENU_WIDTH / 2;
	const uint32_t y = MENU_HEIGHT / 2;
	const uint32_t startAngle = 30;

	menuBuffer.loadFont(Roboto_Bold_48);
	menuBuffer.setTextDatum(MC_DATUM);
	menuBuffer.setTextColor(TFT_WHITE, TFT_BLACK, true);
	menuBuffer.fillSprite(TFT_BLACK);
	buttonState = NOT_PRESSED;

	uint16_t totalTime = totalTimeSeconds * 1000;
	unsigned long endTime = millis() + totalTime;

	while (millis() < endTime && buttonState == NOT_PRESSED) {
		TickType_t xLastWakeTime = xTaskGetTickCount();

		uint16_t timeLeft = endTime - millis();

		snprintf(timeText, sizeof(timeText), "  %0.1f  ", float(timeLeft) / 1000.0);
		uint32_t endAngle = startAngle + ((float(timeLeft) / float(totalTime)) * (360 - 2 * startAngle));

		menuBuffer.drawString(timeText, x, y);
		menuBuffer.drawSmoothArc(x, y, 78, 70, startAngle, (360 - startAngle), TFT_DARKGREY, TFT_BLACK, true);
		if (endAngle - startAngle > 0) menuBuffer.drawSmoothArc(x, y, 78, 70, startAngle, endAngle, TFT_GREEN, TFT_BLACK, true);

		menuBuffer.pushSprite(20, 40);

		xTaskDelayUntil(&xLastWakeTime, pdMS_TO_TICKS(33));
	}
	menuBuffer.setTextColor(TFT_WHITE, TFT_WHITE, false);
	menuBuffer.unloadFont();

	return buttonState == NOT_PRESSED;
}

void drawGPSView() {
	menuBuffer.printf("%02d-%02d-%02d %02d:%02d\n", gps.date.year(), gps.date.month(), gps.date.day(), gps.time.hour(),
					  gps.time.minute());
	menuBuffer.printf("%0.4f,%0.4f\n", gps.location.lat(), gps.location.lng());
	menuBuffer.printf("HDOP %0.1f\n", gps.hdop.hdop());
	menuBuffer.printf("Sat Track:%i View:%i\n", gps.satellitesTracked.value(), gps.satellites.value());
	menuBuffer.printf("Current TTFF %iS\n", gps.timeToFirstFix() / 1000);
	menuBuffer.printf("Average TTFF: %0.1fS\n", averageGPSTimeToLocationFixSeconds);
	menuBuffer.printf("Serial: %i\n", gps.charsProcessed());
}

void drawSatelliteView() {
#define SIZE MENU_HEIGHT
#define X_POS (MENU_WIDTH - SIZE) / 2
#define Y_POS 0
#define CENTRE_X (SIZE / 2) + X_POS
#define CENTRE_Y (SIZE / 2) + Y_POS

	menuBuffer.drawSmoothCircle(CENTRE_X, CENTRE_Y, SIZE / 2, TFT_DARKGREY, TFT_BLACK);
	menuBuffer.drawFastHLine(X_POS, CENTRE_Y, SIZE, TFT_DARKGREY);
	menuBuffer.drawFastVLine(CENTRE_X, Y_POS, SIZE, TFT_DARKGREY);

	for (size_t i = 0; i < gps.satellitesTracked.value(); i++) {

		double radians = (gps.trackedSatellites[i].azimuth) / 57.2957795;
		double radius = ((90 - gps.trackedSatellites[i].elevation) / 90.0) * (SIZE / 2.0);
		int32_t xVal = int32_t(radius * sin(radians));
		int32_t yVal = -int32_t(radius * cos(radians));

		uint8_t signalStrength = map(gps.trackedSatellites[i].strength, 0, 40, 0, 255);
		uint16_t satelliteColor = menuBuffer.color565(0, signalStrength, 0);
		menuBuffer.fillCircle(CENTRE_X + xVal, CENTRE_Y + yVal, 2, satelliteColor);
	}
}

void drawDeviceInfo() {
	menuBuffer.printf("%s Rev %i\n", ESP.getChipModel(), ESP.getChipRevision());
	menuBuffer.setTextColor(TFT_LIGHTGREY);
	menuBuffer.printf("   %i core @ %iMHz\n", ESP.getChipCores(), ESP.getCpuFreqMHz());
	menuBuffer.setTextColor(TFT_WHITE);
	menuBuffer.println("FLASH");
	menuBuffer.setTextColor(TFT_LIGHTGREY);
	menuBuffer.printf("   Size: %.0fMiB@%.0fMHz\n", static_cast<float>(ESP.getFlashChipSize()) / (1024.0 * 1024.0), static_cast<float>(ESP.getFlashChipSpeed()) / (1000.0 * 1000.0));
	menuBuffer.setTextColor(TFT_WHITE);
	menuBuffer.println("FATFS");
	menuBuffer.setTextColor(TFT_LIGHTGREY);
	menuBuffer.printf("   Size: %.0f KB\n", static_cast<float>(flash.size()) / 1024.0);
	menuBuffer.printf("   Used: %.0f%%\n", 100.0 - (static_cast<float>(fatfs.freeClusterCount()) / static_cast<float>(fatfs.clusterCount()) * 100.0));
	menuBuffer.setTextColor(TFT_WHITE);
	menuBuffer.printf("%s\n", ENV);
}

void drawBatteryInfo() {
	menuBuffer.printf("Battery: %imV\n", batteryMilliVolts);
}

void drawSensors() {
	menuBuffer.printf("pH: %0.1f > %0.2f\n", pH.raw, pH.value);
	menuBuffer.printf("ORP: %0.1f > %0.1f\n", orp.raw, orp.value);
	menuBuffer.printf("TDS: %0.1f > %0.1f\n", tds.raw, tds.value);
	menuBuffer.println();

	double pHparameters[2];
	pHRegression.parameters(pHparameters);

	double ORPparameters[2];
	orpRegression.parameters(ORPparameters);

	double TDSparameters[2];
	tdsRegression.parameters(TDSparameters);

	menuBuffer.printf("pH: Y=%0.3fX+%0.2f\n", pHparameters[0], pHparameters[1]);
	menuBuffer.printf("ORP: Y=%0.3fX+%0.2f\n", ORPparameters[0], ORPparameters[1]);
	menuBuffer.printf("TDS: Y=%0.3fe^(%0.3fX)\n", TDSparameters[0], TDSparameters[1]);
}

void onPageView(MenuComponent *p_menu_component) {
	const char *_name = p_menu_component->get_name();
	void (*drawFunction)() = nullptr;

	if (strcmp(_name, "GPS") == 0) {
		drawFunction = drawGPSView;
	} else if (strcmp(_name, "Satellites") == 0) {
		drawFunction = drawSatelliteView;
	} else if (strcmp(_name, "Device Info") == 0) {
		drawFunction = drawDeviceInfo;
	} else if (strcmp(_name, "Sensors") == 0) {
		drawFunction = drawSensors;
		vTaskResume(sensorTaskHandle);
	} else if (strcmp(_name, "Battery") == 0) {
		drawFunction = drawBatteryInfo;
	}

	vTaskDelay(200 / portTICK_PERIOD_MS);
	buttonState = NOT_PRESSED;
	while (buttonState == NOT_PRESSED) {

		if (drawFunction != nullptr) {
			setupMenuBuffer();
			drawFunction();
			menuBuffer.pushSprite(20, 40);
		}
		drawTopGui();
		vTaskDelay(100 / portTICK_PERIOD_MS);
	}
	vTaskSuspend(sensorTaskHandle);
}

void menuItemSelected(MenuComponent *p_menu_component) {
	setupMenuBuffer();
	menuBuffer.printf("%s selected", p_menu_component->get_name());
	menuBuffer.pushSprite(20, 40);
}

void drawCalibrationPrep(const char *name, bool chooseCalibrate) {
	setupMenuBuffer();

	menuBuffer.setCursor(0, 12);
	menuBuffer.println("Place probe in buffer");
	menuBuffer.println("solution and press ");
	menuBuffer.println("set...");

	static char componentText[24];
	snprintf(componentText, sizeof(componentText), "Set %s", name);
	menuRenderer.renderComponent(2, chooseCalibrate, componentText, "\ue3c9");
	menuRenderer.renderComponent(3, !chooseCalibrate, "Back", "\ue5c4");
	menuBuffer.pushSprite(20, 40);
}

void drawRecord(bool saveToFile) {
	setupMenuBuffer();

	menuBuffer.printf("pH = %0.2f\n", pH.value);
	menuBuffer.printf("ORP = %0.0f mV\n", orp.value);
	menuBuffer.printf("TDS = %0.0f uS/cm\n", tds.value);
	menuBuffer.printf("Temp = %0.1f deg C\n", temperature);

	menuRenderer.renderComponent(2, saveToFile, "Save", "\ue161");
	menuRenderer.renderComponent(3, !saveToFile, "Back", "\ue5c4");
	menuBuffer.pushSprite(20, 40);
}

void onRecord(MenuComponent *p_menu_component) {
	bool saveToFile = true;
	vTaskResume(sensorTaskHandle);

	if (drawSpinner(10)) {
		vTaskSuspend(sensorTaskHandle);
		do {
			drawRecord(saveToFile);
			waitForButtonPress();

			if (buttonState == UP_PRESSED) {
				saveToFile = true;
			} else if (buttonState == DOWN_PRESSED) {
				saveToFile = false;
			}
		} while (buttonState != WAKE_PRESSED);

		if (saveToFile) {
			saveRecordToFile();
		}
	}
	vTaskSuspend(sensorTaskHandle);
}

void onCalibrate(MenuComponent *p_menu_component) {
	const char *_name = p_menu_component->get_name();
	bool chooseCalibrate = false;
	vTaskResume(sensorTaskHandle);

	do {
		drawCalibrationPrep(_name, chooseCalibrate);
		waitForButtonPress();

		if (buttonState == UP_PRESSED) {
			chooseCalibrate = true;
		} else if (buttonState == DOWN_PRESSED) {
			chooseCalibrate = false;
		}
	} while (buttonState != WAKE_PRESSED);

	if (chooseCalibrate == true) {
		if (drawSpinner(30)) {
			if (strcmp(_name, "pH 9.2") == 0) {
				pH.setCurrentCalibrationPoint(0, 9.23);
			} else if (strcmp(_name, "pH 6.9") == 0) {
				pH.setCurrentCalibrationPoint(1, 6.88);
			} else if (strcmp(_name, "pH 4.0") == 0) {
				pH.setCurrentCalibrationPoint(2, 4.00);

			} else if (strcmp(_name, "256mV") == 0) {
				orp.setCalibrationPoint(0, 0, 0);
				orp.setCurrentCalibrationPoint(1, 256);

			} else if (strcmp(_name, ".2g/L NaCl") == 0) {
				tds.setCurrentCalibrationPoint(0, 410);
			} else if (strcmp(_name, ".5g/L NaCl") == 0) {
				tds.setCurrentCalibrationPoint(1, 1008);
			} else if (strcmp(_name, "1g/L NaCl") == 0) {
				tds.setCurrentCalibrationPoint(2, 1990);
			}
		}
		vTaskSuspend(sensorTaskHandle);
	}
}

MenuSystem rootMenu(menuRenderer);
MenuItem measure("Add Record", "\uef3a", &onRecord);

Menu calibrateMenu("Calibrate", "\uea4b");
BackMenuItem calibrateMenuBack("Back", "\ue5c4", NULL, &rootMenu);

Menu phCalibrate("pH", "\uf87a");
MenuItem pH9("pH 9.2", "\ue3c9", &onCalibrate);
MenuItem pH7("pH 6.9", "\ue3c9", &onCalibrate);
MenuItem pH4("pH 4.0", "\ue3c9", &onCalibrate);
BackMenuItem pHBack("Back", "\ue5c4", NULL, &rootMenu);

Menu orpCalibrate("ORP", "\uf878");
MenuItem orp256("256mV", "\ue3c9", &onCalibrate);
BackMenuItem orpBack("Back", "\ue5c4", NULL, &rootMenu);

Menu tdsCalibrate("TDS", "\uf876");
MenuItem tds0(".2g/L NaCl", "\ue3c9", &onCalibrate);
MenuItem tds500(".5g/L NaCl", "\ue3c9", &onCalibrate);
MenuItem tds1000("1g/L NaCl", "\ue3c9", &onCalibrate);
BackMenuItem tdsBack("Back", "\ue5c4", NULL, &rootMenu);

Menu settingsMenu("Settings", "\ue8b8");
MenuItem deviceInfo("Device Info", "\ue88e", &onPageView);
//	NumericMenuItem(const char *name, const char *icon, SelectFnPtr select_fn, float value, float min_value, float max_value, float increment = 1.0, FormatValueFnPtr format_value_fn = nullptr);
NumericMenuItem num("Brightness", "\ue3c9", nullptr, 80.0, 10.0, 100.0, 1.0);
MenuItem batteryInfo("Battery", "\ue206", &onPageView);
BackMenuItem settingsMenuBack("Back", "\ue5c4", NULL, &rootMenu);

Menu debugMenu("Debug", "\ueb8e");
MenuItem gpsStats("GPS", "\ue0c8", &onPageView);
MenuItem satellites("Satellites", "\ue0c8", &onPageView);
MenuItem sensors("Sensors", "\ueb8e", &onPageView);
BackMenuItem debugMenuBack("Back", "\ue5c4", NULL, &rootMenu);

void setupMenu() {
	rootMenu.get_root_menu().add_item(&measure);

	rootMenu.get_root_menu().add_menu(&calibrateMenu);

	calibrateMenu.add_menu(&phCalibrate);
	phCalibrate.add_item(&pH4);
	phCalibrate.add_item(&pH7);
	phCalibrate.add_item(&pH9);
	phCalibrate.add_item(&pHBack);

	calibrateMenu.add_menu(&orpCalibrate);
	orpCalibrate.add_item(&orp256);
	orpCalibrate.add_item(&orpBack);

	calibrateMenu.add_menu(&tdsCalibrate);
	tdsCalibrate.add_item(&tds0);
	tdsCalibrate.add_item(&tds500);
	tdsCalibrate.add_item(&tds1000);
	tdsCalibrate.add_item(&tdsBack);

	calibrateMenu.add_item(&calibrateMenuBack);

	rootMenu.get_root_menu().add_menu(&settingsMenu);
	settingsMenu.add_item(&deviceInfo);
	settingsMenu.add_item(&num);
	settingsMenu.add_item(&batteryInfo);
	settingsMenu.add_item(&settingsMenuBack);

	rootMenu.get_root_menu().add_menu(&debugMenu);
	debugMenu.add_item(&gpsStats);
	debugMenu.add_item(&satellites);
	debugMenu.add_item(&sensors);
	debugMenu.add_item(&debugMenuBack);

	rootMenu.display();
	drawTopGui();
}

void setupButtons() {
	pinMode(WAKE_BUTTON, INPUT);
	pinMode(UP_BUTTON, INPUT);
	pinMode(DOWN_BUTTON, INPUT);
	attachInterrupt(WAKE_BUTTON, buttonISR, RISING);
	attachInterrupt(UP_BUTTON, buttonISR, RISING);
	attachInterrupt(DOWN_BUTTON, buttonISR, RISING);
}

void guiTask(void *parameter) {
#if defined(SPI_EN)
	pinMode(SPI_EN, OUTPUT);
	digitalWrite(SPI_EN, HIGH);
#endif

	setupButtons();

	screen.init();
	screen.setRotation(1);
	screen.fillScreen(TFT_BLACK);

	topGui.setColorDepth(8);
	topGui.createSprite(200, 20);
	topGui.loadFont(Roboto_Bold_24);
	topGui.setTextColor(TFT_WHITE);

	menuBuffer.setColorDepth(8);
	menuBuffer.createSprite(MENU_WIDTH, MENU_HEIGHT);
	menuBuffer.setTextColor(TFT_WHITE);

	setupMenu();

	rootMenu.display();

	pinMode(BACKLIGHT, OUTPUT);
	analogWriteFrequency(10000);
	updateScreenBrightness();

	// if (batteryMilliVolts < 3350) {
	// 	setupMenuBuffer();
	// 	menuBuffer.setTextDatum(MC_DATUM);
	// 	menuBuffer.drawSmoothRoundRect(20, 20, 20, 21, MENU_WIDTH - 40, MENU_HEIGHT - 40, TFT_RED, TFT_BLACK);
	// 	menuBuffer.drawString("0% Battery", MENU_WIDTH / 2, MENU_HEIGHT / 2);
	// 	menuBuffer.pushSprite(20, 40);

	// 	while (true) {
	// 		drawTopGui();
	// 		vTaskDelay(1000 / portTICK_PERIOD_MS);
	// 	}

	// } else {

	while (true) {
		rootMenu.display();
		waitForButtonPress();
		switch (buttonState) {
			case WAKE_PRESSED:
				rootMenu.select();
				break;
			case UP_PRESSED:
				rootMenu.prev();
				break;
			case DOWN_PRESSED:
				rootMenu.next();
				break;
		}
	}
	// }
}
