CDFER/openRiverSense/(commit log)

2023-07-30 setup KiCad
    [openRiverSense_010.kicad_pcb, openRiverSense_010.kicad_sch]
2023-08-31 - alpha board design - UVGL added
    [ATGM332D GPS Feather.kicad_pcb, ATGM332D GPS Feather.kicad_sch, ATGM332D GPS Feather.step, ESP32-S2 ULP UI Feather.kicad_sch, ESP32-S2 ULP UI Feather.step, FeatherWing Battery Doubler.kicad_pcb, FeatherWing Battery Doubler.kicad_sch, JLPCB Panel.kicad_sch]
2023-09-06 refactor into headers fix dateTime
    [Roboto-Bold-24.h, gps.h, gpsOff.h, gpsOn.h, gui.h, main.cpp]
2023-10-18 PCB Design Move to UF2 bootloader Move to Adafruit TinyUSB for mass storage Update Formatting Flip UI orientation Change to PWM Backlight
    [ATGM332D GPS Feather.kicad_pcb, ATGM332D GPS Feather.kicad_sch, ATGM332D GPS Feather.step, ESP32-S2 ULP UI Feather.kicad_sch, ESP32-S2 ULP UI Feather.step, FeatherWing Battery Doubler.kicad_pcb, FeatherWing Battery Doubler.kicad_sch, JLPCB Panel.kicad_sch]
2023-10-22 - setup state machine - add adafruit.io - fix battery soc calculation - increase gps baud rate
    [openRiverSense.kicad_sch]
2023-10-24 basic sensor setup
    [openRiverSense.kicad_sch, probeDaughterBoard.kicad_sch]
2023-10-25 bugfix adc
    [probeDaughterBoard.kicad_sch]
2023-10-31 - rewrite gui - add calibration to gui - add export/import to eeprom
2023-11-01 - add calibration order & points config - add record and save to file - add TDS calibrate
2024-08-28 -added CAD models -moved to KiCAD 8.0 -clang formatting -rebuild sensor calibration -add logging and analytics file -added adaptive backlight -added work hours for gps sync
    [Bottom Shell.3mf, Bottom Shell.stl, Buttons.3mf, Top Shell.stl, openRiverSense.kicad_pcb, openRiverSense.kicad_sch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]
